Mich21050/Zigbee-Smart-Shades/README.md

# Zigbee-Smart-Shades
A smart shade using a ikea trafri zigbee module and other low cost parts. My aim was to create low budget smart shades which were easily integratable into my existing smart home solution. I ended up using the Ikea Tradfri module which is found in almost every Ikea smart bulb which makes it very cheap to obtain.

# Introduction:
This repository includes everything you need to build my Zigbee using the Ikea Tradfri Module smart shades. Thanks to this https://github.com/basilfx/TRADFRI-Hacking great repository from @basilfx it was pretty easy to utilize the Ikea Tradfri module. The main advantage of that is, that you can just pair the shades up to any existing Zigbee smart home solution and it will just work as a light bulb, including the dimming function.
The main 
I got my Module from the cheap GU10 smart lamps (in Austria they cost about 7€ so pretty cheap).

# Concept
So the underlying concept is, just powering the Ikea Tradfri Module using a 3.3V source (Arduino Nano internal regulator) and then reading the PWM output on Pin PB13 (Tradfri Module) using the Arduino Nano and then proccesing the signal to controll a ULN2003 motor controller and a cheap 28byj-48 stepper using the Accelstepper library.

# Disassembling the GU10 bulb
**WARNING: Disassembling the bulb is pretty messy and if you are not carefull it can also be pretty dangerous. You need to carefully seperate the top plastic diffuser from the glass shell of the light. Furthermore if you plugged the bulb in before disassembling it the caps could still hold a little charge so just be carefull.**
1) Carefully seperate the plastic diffuser from the glass shell using a small flathead screwdriver.

2) Once you seperated both of them, unscrew the 2 bolts holding the led pcb in. 

3) Now carefully remove the small metall "heatsink" and the remaining pcb using small pliers.

4) Now you can remove the Tradfri Moduke by just heating up the bottom contacts by adding some new solder and then carefully pulling the module out of its slot.

5) Now solder some pin headers to the the pins shown in the photo below. (Pinout Credits to @basilfx)
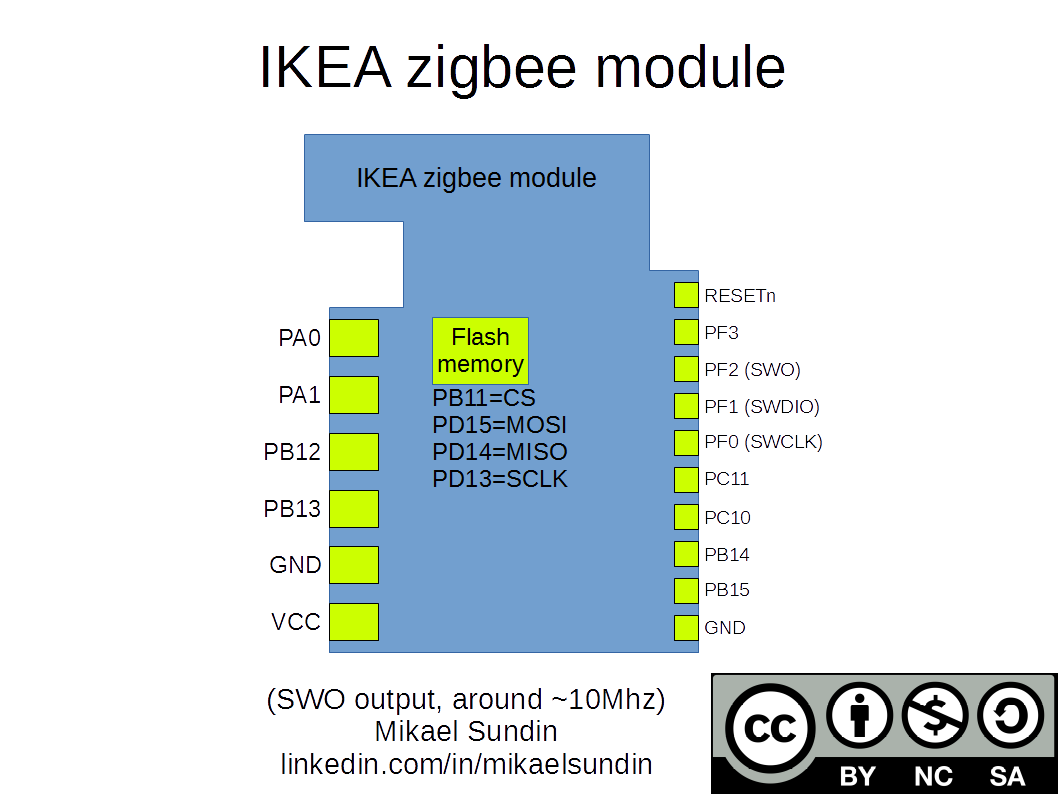
[picture p1: Pictures/pinout.png]
pinout


# Creating the Control Circuit
*I'm currently working on a custom pcb using the same Atmega328p microcontroller and custom tradfri holder.*
I built the original circuit on a breadboard using an Arduino Nano due to its built in 3V3 regulator. 
I also used an external ULN2003 module since those came with my motors and where pretty cheap all around. 
I also decoupled the 3V3 supply for the module using a 68uF capactior since I salvaged it for free from the Tradfri PSU. 
Below you can find a small drawn up circuit and my breadboard circuit. I'm using some JST-XH soldered onto my driver and my pcb.
It's important to note that you have to connect the ULN2003 to a external PSU and not the Nano's 5V out since it won't be able to supply enough current. I just bridged my Vin connector to a Vout one and supplied the Nano using the same 5V supply.

Circuit sketch:
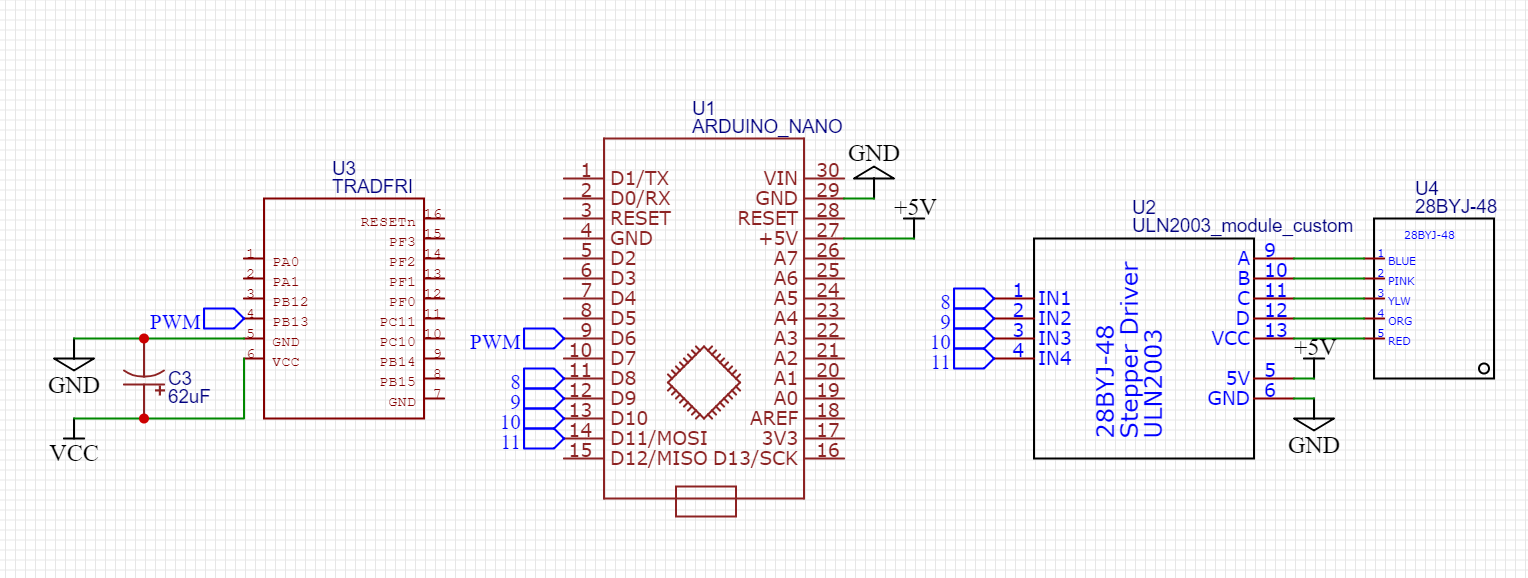
[picture p2: Pictures/pic3.png]


Breadboard circuit:
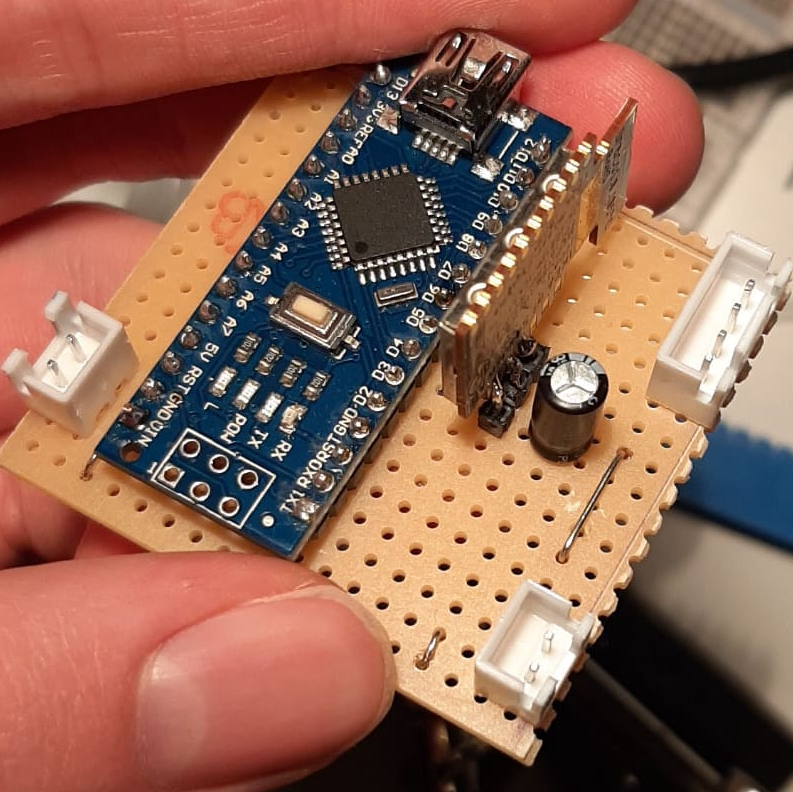
[picture p3: Pictures/pic1.png]


<br />This work is licensed under a <a rel="license" href="http://creativecommons.org/licenses/by-nc-sa/4.0/">Creative Commons Attribution-NonCommercial-ShareAlike 4.0 International License</a>.
